jduanen/LedDisplay/docs/th3l10z-100-.jpg

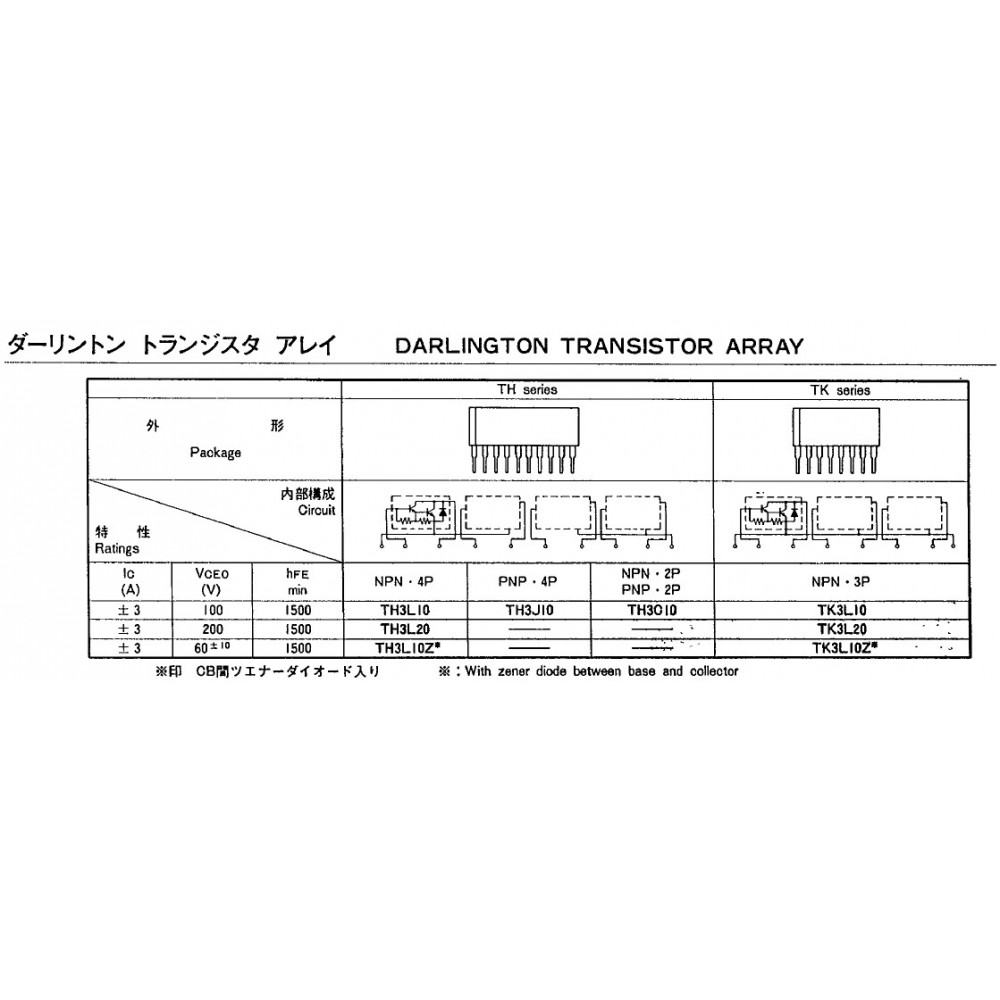
docs/th3l10z-100-.jpg
