jduanen/LedDisplay/ColorLights/src/LedDisplay/Refresh.h

/***************************************************************************
 *
 * LedDisplay Refresh Function for XIAO RP2040
 * 
 ****************************************************************************/

#pragma once


#define DEF_BRIGHTNESS      50  // 50% brightness

#define DEF_ROW_0           D0
#define DEF_ROW_1           D1
#define DEF_ROW_2           D2
#define DEF_REDS_ENB        D3
#define DEF_GREENS_ENB      D4

#define DEF_COL_DATA        D8
#define DEF_COL_STROBE      D9
#define DEF_COL_CLOCK       D5

#define _TX_                D6
#define _RX_                D7

#define NUM_BUFS            3
#define NUM_COLS            ((8 + 8 + 1) * 5)
#define NUM_ROWS            7

#define ROW_DELAY           1500    // 1.5 msec (667 Hz refresh rate)
#define INTER_ROW_DELAY     (ROW_DELAY - _ledsOnDelay)

#define MAX_LEDS_ON_DELAY   0       //   0 usec (0% brightness)
#define DEF_LEDS_ON_DELAY   400     // 400 usec (50% brightness)
#define MIN_LEDS_ON_DELAY   750     // 750 usec (100% brightness)

#define BLACK_COLOR         0b00000000
#define RED_COLOR           0b00000001
#define GREEN_COLOR         0b00000010
#define AMBER_COLOR         (GREEN_COLOR | RED_COLOR)

#define NUM_COLORS          4
#define NUM_LED_COLORS      2
#define BPP                 2


#define BUF_NUM_VALID(num)  (((num) >= 0) && ((num) < NUM_BUFS))

#define LED_COLORS(COLOR_NUM)   (1 << (COLOR_NUM))  // 0: Green, 1: Red


class Refresh {
  public:
    typedef uint8_t frameBuffer[NUM_BUFS][NUM_ROWS][NUM_COLS];

    Refresh();
    Refresh(uint8_t row0, uint8_t row1, uint8_t row2,
            uint8_t greenLedsEnable, uint8_t redLedsEnable,
            uint8_t columnData, uint8_t columnStrobe, uint8_t columnClock);
    ~Refresh();

    void refreshInit();    // N.B. this must be run on the Refresh core
    void refresh();

    uint8_t getBrightness();
    void setBrightness(byte percent);

  protected:
    frameBuffer _frameBuffers = {};

    void shiftInPixels(int bufNum, int row, int color);
    void disableRows();
    void enableRow(int rowColor, int rowNum);

  private:
    uint32_t _ledsOnDelay = DEF_LEDS_ON_DELAY;
    uint8_t _curRow = 0;
    uint8_t _refreshBufNum = -1;  // unallocated
    uint8_t _row0 = DEF_ROW_0;
    uint8_t _row1 = DEF_ROW_1;
    uint8_t _row2 = DEF_ROW_2;
    uint8_t _greensEnable = DEF_GREENS_ENB;
    uint8_t _redsEnable = DEF_REDS_ENB;
    uint8_t _columnData = DEF_COL_DATA;
    uint8_t _columnStrobe = DEF_COL_STROBE;
    uint8_t _columnClock = DEF_COL_CLOCK;

    void init();
};

//#include "Refresh.hpp"
