jduanen/LedDisplay/(commit log)

2023-04-04 Removed prints.
2023-04-04 Fixed led enables.
2023-04-07 Moved outputs to make room for UART.
2023-04-07 Changed frame rate and brightness range.
